juvinski/BBBMINI_V2/PCB/BBBMINI_PCB_V2/BBBMINI_PCB_V2.png

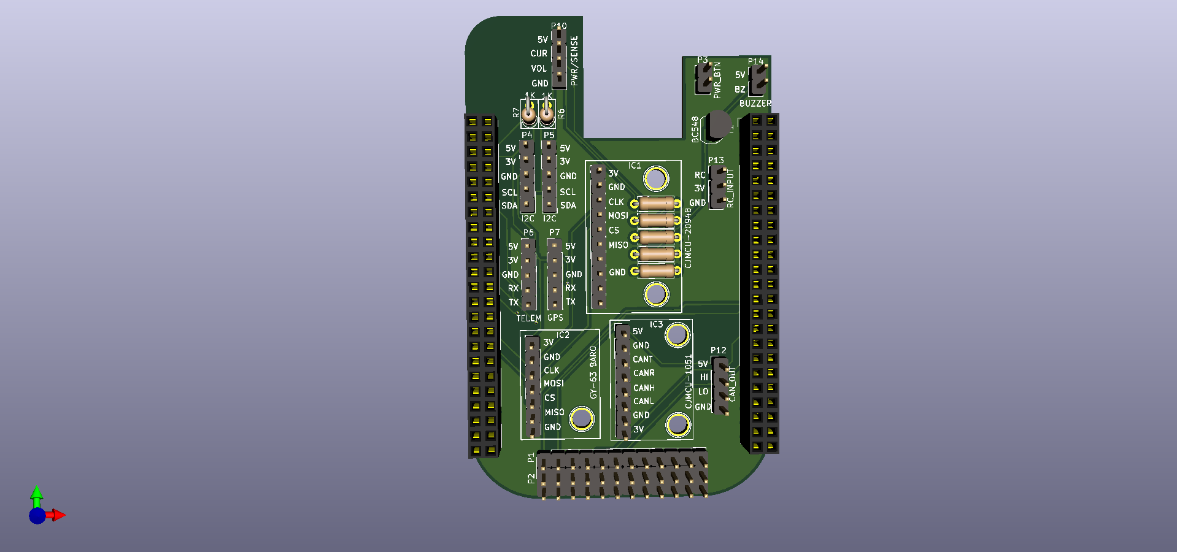
PCB/BBBMINI_PCB_V2/BBBMINI_PCB_V2.png
