juvinski/BBBMINI_V2/README.md

This project is an updated version of the BBBMINI from Mirko Denecke - https://github.com/mirkix/BBBMINI/

This is a cape for Beaglebone Black or Green:

The main differences between BBBMini and BBBMini V2:
* IMU updated to the ICM-20948.
* 3 Serial ports - Telemetry, GPS and Sonar, Lidar or other serial sensor.
* PWM Buzzer with transistor included on the board.
* CAN Bus using breakout sensor board - TJA 1051.
* PullUP resitors for the I2C bus.
* Power Button pinheader.
* ABC leds.
* GPIO pins for relay pins.
* Debian Buster
* Realtime Kernel 5.10.
* Ardupilot 4.2.

# License

<br /><span xmlns:dct="http://purl.org/dc/terms/" property="dct:title">BBBmini V2</span> by <a xmlns:cc="http://creativecommons.org/ns#" href="https://github.com/juvinski" property="cc:attributionName" rel="cc:attributionURL">Vinicius Juvinski</a> is licensed under a <a rel="license" href="http://creativecommons.org/licenses/by-sa/4.0/">Creative Commons Attribution-ShareAlike 4.0 International License</a>.

UNLESS OTHERWISE MUTUALLY AGREED TO BY THE PARTIES IN WRITING, LICENSOR OFFERS THE WORK AS-IS AND MAKES NO REPRESENTATIONS OR WARRANTIES OF ANY KIND CONCERNING THE WORK, EXPRESS, IMPLIED, STATUTORY OR OTHERWISE, INCLUDING, WITHOUT LIMITATION, WARRANTIES OF TITLE, MERCHANTABILITY, FITNESS FOR A PARTICULAR PURPOSE, NONINFRINGEMENT, OR THE ABSENCE OF LATENT OR OTHER DEFECTS, ACCURACY, OR THE PRESENCE OF ABSENCE OF ERRORS, WHETHER OR NOT DISCOVERABLE. SOME JURISDICTIONS DO NOT ALLOW THE EXCLUSION OF IMPLIED WARRANTIES, SO SUCH EXCLUSION MAY NOT APPLY TO YOU. EXCEPT TO THE EXTENT REQUIRED BY APPLICABLE LAW, IN NO EVENT WILL LICENSOR BE LIABLE TO YOU ON ANY LEGAL THEORY FOR ANY SPECIAL, INCIDENTAL, CONSEQUENTIAL, PUNITIVE OR EXEMPLARY DAMAGES ARISING OUT OF THIS LICENSE OR THE USE OF THE WORK, EVEN IF LICENSOR HAS BEEN ADVISED OF THE POSSIBILITY OF SUCH DAMAGES.
