juvinski/BBBMINI_V2/Schematic/Schematic.pdf

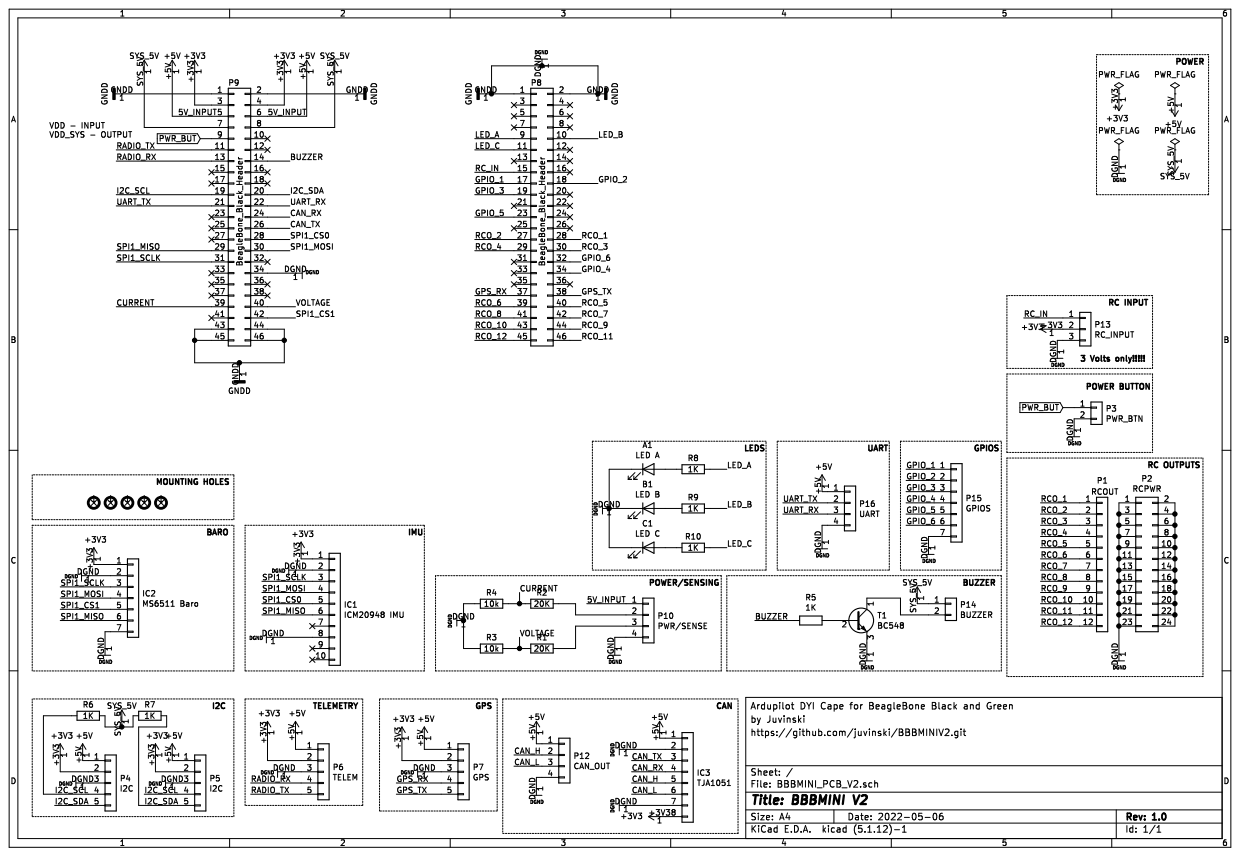
[picture p2: page 1]
