juvinski/BBBMINI_V2/(list of files, drawings)

Other design files:
PCB/BBBMINI_PCB_V2/BBBMINI_PCB_V2.dsn
