juvinski/BBBMINI_V2/PCB/BBBMINI_PCB_V2/BBBMINI_PCB_V2.kicad_pcb

## KiCad design PCB/BBBMINI_PCB_V2/BBBMINI_PCB_V2.kicad_pcb (2022-05-11)

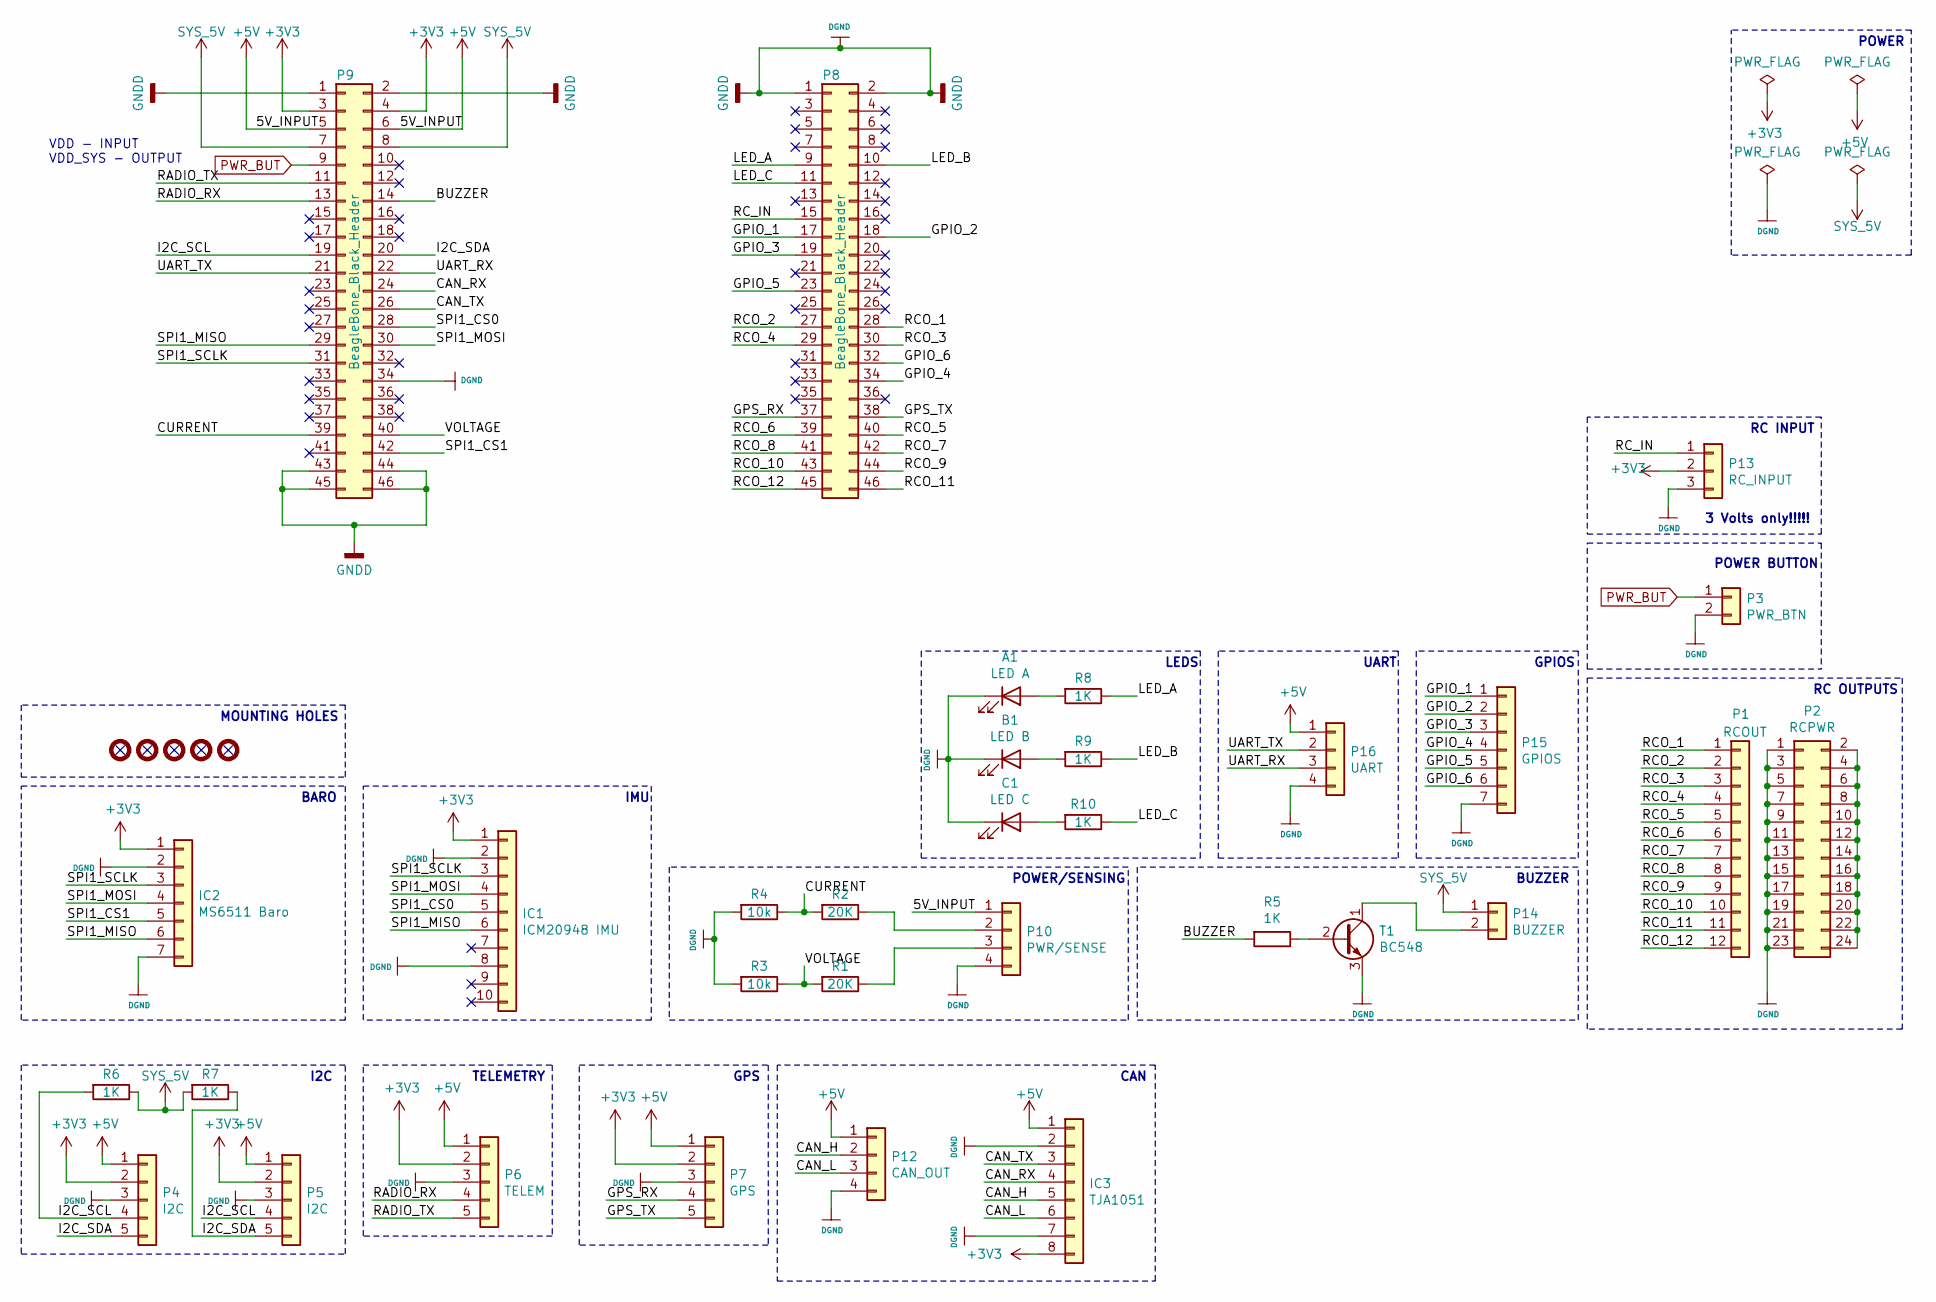
[picture p3: schematic BBBMINI_PCB_V2.sch, BBBMINI V2]

Parts:
A1: LED A; LED_D1.8mm_W3.3mm_H2.4mm
B1: LED B; LED_D1.8mm_W3.3mm_H2.4mm
C1: LED C; LED_D1.8mm_W3.3mm_H2.4mm
IC1: ICM20948 IMU; PinHeader_1x10_P2.54mm_Vertical
IC2: MS6511 Baro; PinHeader_1x07_P2.54mm_Vertical
IC3: TJA1051; PinHeader_1x08_P2.54mm_Vertical
M1: MOUNTING-HOLE; MountingHole_2.2mm_M2_Pad
M2, M3, M4, M5: M; MountingHole_2.2mm_M2_Pad
P1: RCOUT; PinHeader_1x12_P2.54mm_Vertical
P2: RCPWR; PinHeader_2x12_P2.54mm_Vertical
P3: PWR_BTN; PinHeader_1x02_P2.54mm_Vertical
P4, P5: I2C; PinHeader_1x05_P2.54mm_Vertical
P6: TELEM; PinHeader_1x05_P2.54mm_Vertical
P7: GPS; PinHeader_1x05_P2.54mm_Vertical
P8, P9: BeagleBone_Black_Header; Socket_BeagleBone_Black
P10: PWR/SENSE; PinHeader_1x04_P2.54mm_Vertical
P12: CAN_OUT; PinHeader_1x04_P2.54mm_Vertical
P13: RC_INPUT; PinHeader_1x03_P2.54mm_Vertical
P14: BUZZER; PinHeader_1x02_P2.54mm_Vertical
P15: GPIOS; PinHeader_1x07_P2.54mm_Vertical
P16: UART; PinHeader_1x04_P2.54mm_Vertical
R1, R2: 20K; R_Axial_DIN0207_L6.3mm_D2.5mm_P7.62mm_Horizontal
R3, R4: 10k; R_Axial_DIN0207_L6.3mm_D2.5mm_P7.62mm_Horizontal
R5: 1K; R_Axial_DIN0207_L6.3mm_D2.5mm_P7.62mm_Horizontal
R6, R7, R8, R9, R10: 1K; R_Axial_DIN0207_L6.3mm_D2.5mm_P2.54mm_Vertical
T1: BC548; TO-92_Inline

Connections:
+3V3: IC1.1, IC2.1, IC3.8, P4.2, P5.2, P6.2, P7.2, P9.3, P9.4, P13.2
+5V: IC3.1, P4.1, P5.1, P6.1, P7.1, P9.5, P9.6, P10.1, P12.1, P16.1
/BUZZER: P9.14, R5.2
/CAN_H: IC3.5, P12.2
/CAN_L: IC3.6, P12.3
/CAN_RX: IC3.4, P9.24
/CAN_TX: IC3.3, P9.26
/CURRENT: P9.39, R2.2, R4.1
/GPIO_1: P8.17, P15.1
/GPIO_2: P8.18, P15.2
/GPIO_3: P8.19, P15.3
/GPIO_4: P8.34, P15.4
/GPIO_5: P8.23, P15.5
/GPIO_6: P8.32, P15.6
/GPS_RX: P7.4, P8.37
/GPS_TX: P7.5, P8.38
/I2C_SCL: P4.4, P5.4, P9.19, R6.2
/I2C_SDA: P4.5, P5.5, P9.20, R7.1
/LED_A: P8.9, R8.1
/LED_B: P8.10, R9.1
/LED_C: P8.11, R10.1
/RADIO_RX: P6.4, P9.13
/RADIO_TX: P6.5, P9.11
/RCO_1: P1.1, P8.28
/RCO_2: P1.2, P8.27
/RCO_3: P1.3, P8.30
/RCO_4: P1.4, P8.29
/RCO_5: P1.5, P8.40
/RCO_6: P1.6, P8.39
/RCO_7: P1.7, P8.42
/RCO_8: P1.8, P8.41
/RCO_9: P1.9, P8.44
/RCO_10: P1.10, P8.43
/RCO_11: P1.11, P8.46
/RCO_12: P1.12, P8.45
/RC_IN: P8.15, P13.1
/SPI1_CS0: IC1.5, P9.28
/SPI1_CS1: IC2.5, P9.42
/SPI1_MISO: IC1.6, IC2.6, P9.29
/SPI1_MOSI: IC1.4, IC2.4, P9.30
/SPI1_SCLK: IC1.3, IC2.3, P9.31
/UART_RX: P9.22, P16.3
/UART_TX: P9.21, P16.2
/VOLTAGE: P9.40, R1.2, R3.1
DGND: A1.1 (K), B1.1 (K), C1.1 (K), IC1.2, IC1.8, IC2.2, IC2.7, IC3.2, IC3.7, P2.1, P2.3, P2.5, P2.7, P2.9, P2.11, P2.13, P2.15, P2.17, P2.19, P2.21, P2.23, P3.2, P4.3, P5.3, P6.3, P7.3, P8.1, P8.2, P9.1, P9.2, P9.34, P9.43, P9.44, P9.45, P9.46, P10.4, P12.4, P13.3, P15.7, P16.4, R3.2, R4.2, T1.3 (E)
unnamed: A1.2 (A), R8.2
unnamed: B1.2 (A), R9.2
unnamed: C1.2 (A), R10.2
unnamed: P2.2, P2.4, P2.6, P2.8, P2.10, P2.12, P2.14, P2.16, P2.18, P2.20, P2.22, P2.24
unnamed: P10.2, R2.1
unnamed: P10.3, R1.1
unnamed: P14.2, T1.1 (C)
unnamed: R5.1, T1.2 (B)
PWR_BUT: P3.1, P9.9
SYS_5V: P9.7, P9.8, P14.1, R6.1, R7.2

Notes on the sheet:
VDD - INPUT VDD_SYS - OUTPUT
RC OUTPUTS
POWER BUTTON
I2C
TELEMETRY
GPS
BARO
POWER
IMU
CAN
POWER/SENSING
RC INPUT
3 Volts only!!!!!
BUZZER
GPIOS
UART
MOUNTING HOLES
LEDS

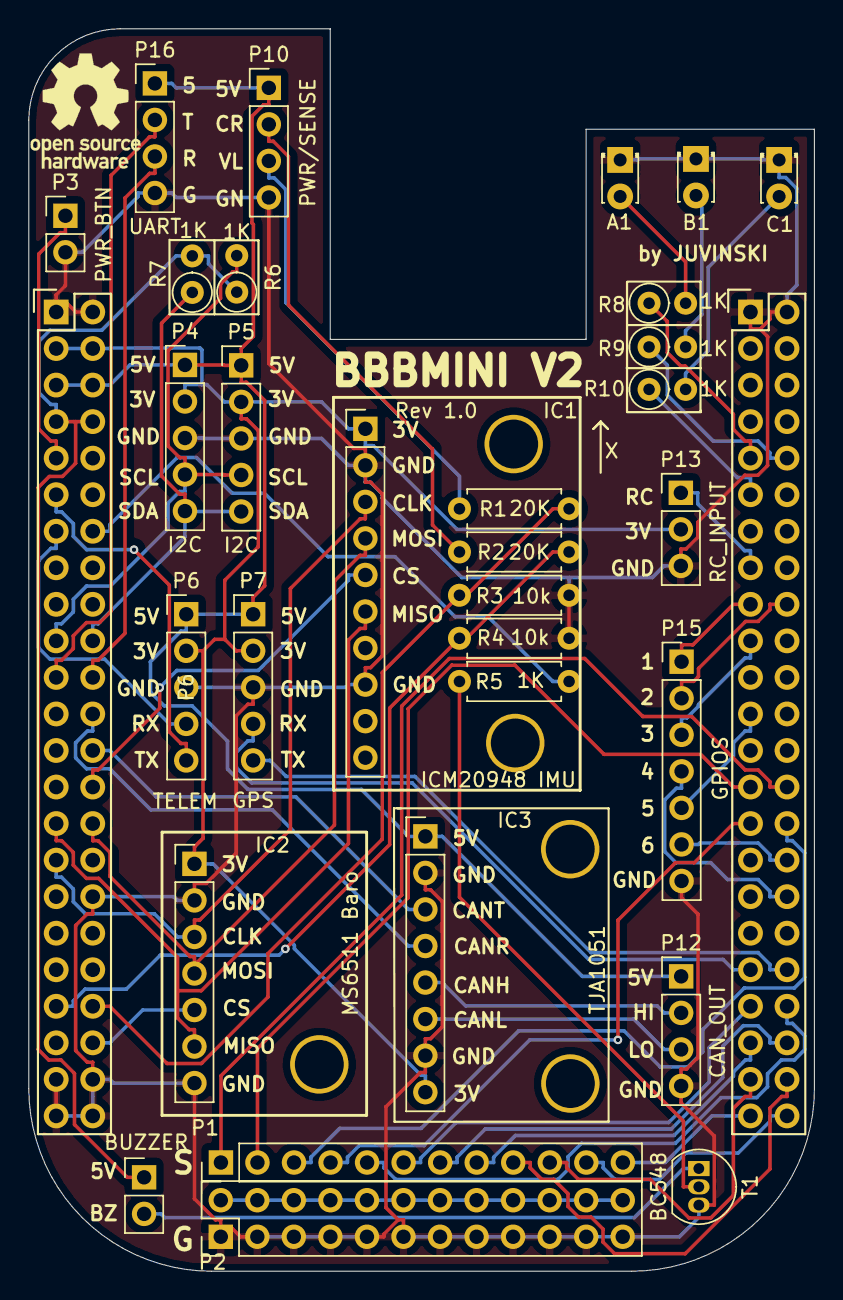
[picture p4: board BBBMINI_PCB_V2.kicad_pcb from above]

Board: 2 copper layers, 54.6 x 86.4 mm, 37 parts (0 on the bottom side), 55 nets.
