juvinski/BBBMINI_V2/(threads)

Thread 1 (2022-06-01):

unable to open SPI bus /dev/spidev2.1: No such file or directory & IMU Errors (MPU-9250)

safinwb, 2022-06-01:
I have updated the uEnv.txt

Not sure what i am missing out:
When I list the SPI devices using `ls /dev/spidev*`:

`/dev/spidev0.0  /dev/spidev1.0  /dev/spidev1.1`

When I run Ardurover:
```
Init ArduRover V4.2.0-rc4 (8ee85bdb)

Free RAM: 262144
SPI: unable to open SPI bus /dev/spidev2.1: No such file or directory
```
My uEnv.txt file:

```
#Docs: http://elinux.org/Beagleboard:U-boot_partitioning_layout_2.0

uname_r=5.10.109-bone-rt-r63
#uuid=
dtb=am335x-boneblack-bbbmini.dtb

###U-Boot Overlays###
###Documentation: http://elinux.org/Beagleboard:BeagleBoneBlack_Debian#U-Boot_Overlays
###Master Enable
#enable_uboot_overlays=1
###
###Overide capes with eeprom
#uboot_overlay_addr0=<file0>.dtbo
#uboot_overlay_addr1=<file1>.dtbo
#uboot_overlay_addr2=<file2>.dtbo
#uboot_overlay_addr3=<file3>.dtbo
###
###Additional custom capes
#uboot_overlay_addr4=<file4>.dtbo
#uboot_overlay_addr5=<file5>.dtbo
#uboot_overlay_addr6=<file6>.dtbo
#uboot_overlay_addr7=<file7>.dtbo
###
###Custom Cape
#dtb_overlay=<file8>.dtbo
###
###Disable auto loading of virtual capes (emmc/video/wireless/adc)
#disable_uboot_overlay_emmc=1
#disable_uboot_overlay_video=1
#disable_uboot_overlay_audio=1
#disable_uboot_overlay_wireless=1
#disable_uboot_overlay_adc=1
###
###PRUSS OPTIONS
###pru_rproc (4.14.x-ti kernel)
#uboot_overlay_pru=AM335X-PRU-RPROC-4-14-TI-00A0.dtbo
###pru_rproc (4.19.x-ti kernel)
#uboot_overlay_pru=AM335X-PRU-RPROC-4-19-TI-00A0.dtbo
###pru_uio (4.14.x-ti, 4.19.x-ti & mainline/bone kernel)
uboot_overlay_pru=AM335X-PRU-UIO-00A0.dtbo
###
###Cape Universal Enable
#enable_uboot_cape_universal=1
###
###Debug: disable uboot autoload of Cape
#disable_uboot_overlay_addr0=1
#disable_uboot_overlay_addr1=1
#disable_uboot_overlay_addr2=1
#disable_uboot_overlay_addr3=1
###
###U-Boot fdt tweaks... (60000 = 384KB)
#uboot_fdt_buffer=0x60000
###U-Boot Overlays###

console=ttyS0,115200n8
cmdline=coherent_pool=1M net.ifnames=0 lpj=1990656 rng_core.default_quality=100 quiet

#In the event of edid real failures, uncomment this next line:
#cmdline=coherent_pool=1M net.ifnames=0 lpj=1990656 rng_core.default_quality=100 quiet video=HDMI-A-1:1024x768@60e

#Use an overlayfs on top of a read-only root filesystem:
#cmdline=coherent_pool=1M net.ifnames=0 lpj=1990656 rng_core.default_quality=100 quiet overlayroot=tmpfs

##enable Generic eMMC Flasher:
#cmdline=init=/opt/scripts/tools/eMMC/init-eMMC-flasher-v3.sh
```

juvinski, 2022-06-01:
Hi,

could you please run a
ls /dev/i2c*

to see if the ports is detected ?

safinwb, 2022-06-02:
They are detected:
`
/dev/i2c-0  /dev/i2c-2
`

safinwb, 2022-06-02:
I have attached boot messages:

Here is current:
[am355_env.txt](https://github.com/juvinski/BBBMINI_V2/files/8823515/am355_env.txt)

Here was my previous working one:
[old_env.txt](https://github.com/juvinski/BBBMINI_V2/files/8823516/old_env.txt)

juvinski, 2022-06-02:
Hi @safinwb

the dtb is ok once there is no i2c-1
I don’t know why - I asked a lot of times , this dtb instead generate the spidev 2 is generating 0 and 1.

there is two ways. You can change ardupilot code to use the spidev 0 and 1 or you can create a symlink for spidev 2 - sudo ln -s /dev/spidev1.0 /dev/spidev2.0 and sudo ln -s /dev/spidev1.1 /dev/spidev2.1

the symlimk must be created on every boot - you can create  rc.local script for that or on the ardupilot service file call a script to create this symlinks

safinwb, 2022-06-03:
I will go the route of doing symlink, the only error I am getting now is
`
Config Error: Baro: unable to initialise driver
`

When I run MPU9250 test:
`
MPU 9250 Test
MPU9250: Onboard IMU detected
AK8963: Onboard compass detected
`

When I run ms5611_test:
`
MS5611 test
MS5611 detected successfully!
Pressure:100490.98 Temperature:40.01 Altitude:0.04 climb=0.25 t=15
Pressure:100492.79 Temperature:40.03 Altitude:-0.12 climb=1.45 t=14
Pressure:100493.03 Temperature:40.04 Altitude:-0.14 climb=2.48 t=13
`

safinwb, 2022-06-03:
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

Okay for this issue, I have to set SPI devices in my AP_HAL_LINUX setup in ardupilot code. I have things going crazy now, but atleast it is showing up on mission planner now.

Things going crazy: IMU/Compass acting wierd; will look more into it after the weekend.

juvinski, 2022-06-03:
You need to disable the ins_fastrate in the parameters , without that you will have several imu errors

safinwb, 2022-06-04:
yep, INS_FAST_SAMPLE is set to 0, but the IMU keeps resetting by EKF3

juvinski, 2022-06-04:
If I not wrong, the 0 is enabled for imu 0 - https://ardupilot.org/copter/docs/parameters.html#ins-fast-sample-fast-sampling-mask

check the messages in mission planner to see if there is error or imu reset.

safinwb, 2022-06-04:
When I set it to 1:
` IMU0: fast sampling enabled 8.0KHz/1.0Hz `

When I set it to 0: It doesn't show the fast sampling enable message.

Regardless: i get the same reset message when i run the binary.

In mission planner messages(with both INS_FAST_SAMPLE on and off):
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

juvinski, 2022-06-05:
That is the reason I updated to use the ICM20948 - with this IMU I never had problems.
In my board with mpu9250 I have 1 imu forces reset at every 5 or 10 minutes with fast sample disabled, with enabled I have several error messages.

safinwb, 2022-06-05:
the wierd thing is I've never noticed this error with using this IMU till i put on 4.2, or maybe it was less frequent like you said that i haven't seen it. I'll try to see if it's something I'm missing in setting up the IMU to make this work.

Now looks like ICM-29948 is out of stock everywhere or super inflated prices, even out of stock build your own breakout 😅

juvinski, 2022-06-06:
Hi @safinwb ,
I compared the codes since the 3.8 and I didn't see any change in the spi lower level functions - open, read and write, so I believe or is something in the linux kernel or something inside the EKF3 - the major difference between 3.x to 4.x version of ardupilot.
I tested with the icm and everything is working fine without any error.
I believe - once the mpu-9250 is EOL and there are several in the market what I believe there is no shortage problem, meanwhile I believe the ICM is facing this shortage problem because today price in aliexpress is around U$ 35, and in 2020 I paid around U$ 5 per unit.

safinwb, 2022-06-07:
Yep you struck your luck with that $5 modules 😅

It's not the kernel problem as i ran my older code (which is mix and match of versions between 3.5-3.8), and it worked fine with MPU-9250 on this kernel. So it's definitely EK3. I'm going to try other stuff to see why this is happening.

juvinski, 2022-06-07:
You can try to update again to the 5.10 and Ardupilot 4.2 and disable ekf3 and enable ekf2 to see what can happen.

safinwb, 2022-06-07:
Okat that was the root of all problems, even spidev, i think:

Because I set it 2,1 - 2,0 - 1,0; I was getting SPI error, and the speed. Had it to set it to whatever SPI was detecting

    SPIDesc("mpu9250",    2, 1, SPI_MODE_0, 8, SPI_CS_KERNEL,  1*MHZ, 10*MHZ),
    SPIDesc("ms5611",     2, 0, SPI_MODE_0, 8, SPI_CS_KERNEL,  10*MHZ,10*MHZ),
    SPIDesc("ublox",      1, 0, SPI_MODE_0, 8, SPI_CS_KERNEL,  5*MHZ, 5*MHZ),

Closed 2022-06-07.

Thread 2 (2022-06-16):

No PWM Output

safinwb, 2022-06-16:
Successfully tested other stuff out with the kernel, but today when i set my servos up - there is no pwm output, even with logic analyzer it shows low.

Anything I should be looking for ?

safinwb, 2022-06-17:
Didn't notice the default pru was commented out:

`&pruss {
	pinctrl-names = "default";
	pinctrl-0 = <&pru_pins>;
	status = "okay";
};`

juvinski, 2022-06-17:
How you was trying to use the servos ?
By default you should use the pru - output pins for that - once they use the PRU to generate the pwm pulses - ardupilot generate values on the shared memory and the pru reads this space and generate the pwm output on the channel.
Under ardupilot, on the SERVOX_Function you should set as servo if I not wrong - or on the mission planner there is a servo tab and you can set outputs as servo outputs and then use it.

Closed 2022-06-17.

Thread 4 (2023-11-13):

Trying to compile I get "Invalid board 'bbbmini-v2"

Seeelefant, 2023-11-13:
Trying to compile  Arducopter I get "Invalid board 'bbbmini-v2':

```
**********@**********-virtual-machine:~/temp/ardupilot$ ./waf configure --board=bbbmini-v2
Setting top to                           : /home/**********/temp/ardupilot
Setting out to                           : /home/**********/temp/ardupilot/build
Autoconfiguration                        : enabled
Setting board to                         : bbbmini-v2
Invalid board 'bbbmini-v2': choices are aero, airbotf4, AIRLink, ARK_GPS, bbbmini, BeastF7, BeastF7v2, BeastH7, BeastH7v2, bebop, bhat, BirdCANdy, blue, CarbonixL496, crazyflie2, CUAV-Nora, CUAV-X7, CUAV-X7-bdshot, CUAV_GPS, CUAVv5, CUAVv5-bdshot, CUAVv5Nano, CUAVv5Nano-bdshot, CubeBlack, CubeBlack+, CubeBlack-periph, CubeGreen-solo, CubeOrange, CubeOrange-bdshot, CubeOrange-joey, CubeOrange-ODID, CubeOrange-periph, CubeOrange-periph-heavy, CubeOrangePlus, CubePurple, CubeSolo, CubeYellow, CubeYellow-bdshot, dark, DevEBoxH7v2, disco, DrotekP3Pro, Durandal, Durandal-bdshot, edge, erleboard, erlebrain2, esp32buzz, esp32diy, f103-ADSB, f103-Airspeed, f103-GPS, f103-HWESC, f103-QiotekPeriph, f103-RangeFinder, f103-Trigger, f303-GPS, f303-HWESC, f303-M10025, f303-M10070, f303-MatekGPS, f303-PWM, f303-Universal, F35Lightning, f405-MatekAirspeed, f405-MatekGPS, F4BY, FlyingMoonF407, FlyingMoonF427, FlywooF745, FlywooF745Nano, fmuv2, fmuv3, fmuv3-bdshot, fmuv5, FreeflyRTK, G4-ESC, H757I_EVAL, H757I_EVAL_intf, HereID, HerePro, Hitec-Airspeed, HitecMosaic, HolybroG4_GPS, HolybroGPS, iomcu, iomcu_f103_8MHz, JHEMCU-GSF405A, JHEMCU-GSF405A-RX2, KakuteF4, KakuteF4Mini, KakuteF7, KakuteF7-bdshot, KakuteF7Mini, KakuteH7, KakuteH7-bdshot, KakuteH7Mini, linux, luminousbee4, luminousbee5, MambaF405-2022, MambaF405US-I2C, MambaF405v2, MambaH743v4, MatekF405, MatekF405-bdshot, MatekF405-CAN, MatekF405-STD, MatekF405-TE, MatekF405-Wing, MatekF765-SE, MatekF765-Wing, MatekF765-Wing-bdshot, MatekH743, MatekH743-bdshot, MatekH743-periph, MazzyStarDrone, mindpx-v2, mini-pix, modalai_fc-v1, mRo-M10095, mRoControlZeroClassic, mRoControlZeroF7, mRoControlZeroH7, mRoControlZeroH7-bdshot, mRoControlZeroOEMH7, mRoNexus, mRoPixracerPro, mRoPixracerPro-bdshot, mRoX21, mRoX21-777, navigator, navio, navio2, Nucleo-G491, Nucleo-L476, Nucleo-L496, NucleoH743, obal, ocpoc_zynq, omnibusf4, omnibusf4pro, omnibusf4pro-bdshot, omnibusf4pro-one, omnibusf4v6, OMNIBUSF7V2, OMNIBUSF7V2-bdshot, OmnibusNanoV6, OmnibusNanoV6-bdshot, PH4-mini, Pix32v5, PixC4-Jetson, Pixhawk1, Pixhawk1-1M, Pixhawk1-1M-bdshot, Pixhawk4, Pixhawk4-bdshot, Pixhawk5X, Pixhawk6C, Pixhawk6X, Pixhawk6X-ODID, Pixracer, Pixracer-bdshot, Pixracer-periph, PixSurveyA1, pocket, pxf, pxfmini, QioTekZealotF427, QioTekZealotH743, R9Pilot, ReaperF745v2, revo-mini, revo-mini-bdshot, revo-mini-i2c, revo-mini-i2c-bdshot, rst_zynq, Sierra-F405, Sierra-F412, Sierra-F9P, Sierra-L431, sitl, SITL_arm_linux_gnueabihf, sitl_periph_gps, SITL_static, SITL_x86_64_linux_gnu, skyviper-f412-rev1, skyviper-journey, skyviper-v2450, sparky2, speedybeef4, SPRacingH7, SuccexF4, Swan-K1, TBS-Colibri-F7, vnav, VRBrain-v51, VRBrain-v52, VRBrain-v54, VRCore-v10, VRUBrain-v51, ZubaxGNSS, zynq
(complete log in /home/**********/temp/ardupilot/build/config.log)
```

Please advice.
